AhmedYehia-M23/low-noise-microphone-preamplifier/simulation/ltspice/Microphone_Preamplifier_AD8656.asc

C1: polcap; 10µ; Rser=4 Lser=0 mfg="AVX" pn="TAJA106M006" type="Tantalum"
C2: Cap; 100nF
C3: Cap; 27nF
C5: Cap; 100nF
C6: Cap; 10µF
C7: polcap; 4.7µF
I1: current; SINE(250u 1u 1k); AC 1u
R1: res; 10K
R2: res; 10K
R3: Res; 47k
R4: Res; 2.2k
R5: Res; 22K
R6: Res; 220
R7: Res; 330
R8: Res; 100K
RPOT: Res; {Rpot}
U1: opamp2; AD8656
U2: opamp2; AD8656
V3: Voltage; 5V
Named nets: 0, VREF_RAW, VBIAS, VREF, LPF_OUT, 5V, MIC_OUT, AUDIO_OUT
Low-Noise Electret Microphone Preamplifier
5 V Supply & Decoupling
Mid-Supply Reference Generator (VREF_RAW)
Buffered Mid-Supply Reference (VREF)
Electret Microphone Input Stage
Main Gain Stage
Low-Pass Output Filter
AC-Coupled Audio Output
Simulation - 30 dB AC Response
.include ad8656.cir
.param Rpot=500
.ac dec 100 1 1Meg
.meas AC Gain_1k FIND db(V(audio_out)/V(mic_out)) AT=1k
.meas AC F_LOW WHEN db(V(audio_out)/V(mic_out))=26.5132 RISE=1
.meas AC F_HIGH WHEN db(V(audio_out)/V(mic_out))=26.5132 FALL=1
