AhmedYehia-M23/low-noise-microphone-preamplifier/simulation/ltspice/Microphone_Preamplifier_OPA165x.asc

C1: polcap; 10µ; Rser=4 Lser=0 mfg="AVX" pn="TAJA106M006" type="Tantalum"
C2: Cap; 100nF
C3: Cap; 27nF
C5: Cap; 100nF
C6: Cap; 10µF
C7: polcap; 4.7µF
I1: current; SINE(250u 5.1u 1k); AC 1
R1: res; 10K
R2: res; 10K
R3: Res; 47k
R4: Res; 2.2k
R5: Res; 22K
R6: Res; 220
R7: Res; 330
R8: Res; 100K
RPOT: Res; {Rpot}
U1: opamp2; OPA165x
U2: opamp2; OPA165x
V3: Voltage; 5V
Named nets: 0, VREF_RAW, VBIAS, VREF, LPF_OUT, 5V, MIC_OUT, AUDIO_OUT
.include OPA165x.LIB
.step param Rpot list 1 179 500
.ac dec 100 1 1Meg
.tran 10m
.param Rpot=500
Low-Noise Electret Microphone Preamplifier
5 V Supply & Decoupling
Mid-Supply Reference Generator (VREF_RAW)
Buffered Mid-Supply Reference (VREF)
Electret Microphone Input Stage
Main Gain Stage
Low-Pass Output Filter
AC-Coupled Audio Output
Simulation Commands
.op
