AhmedYehia-M23/low-noise-microphone-preamplifier/hardware/kicad/Microphone.kicad_pcb

## KiCad design hardware/kicad/Microphone.kicad_pcb (2026-10-14)

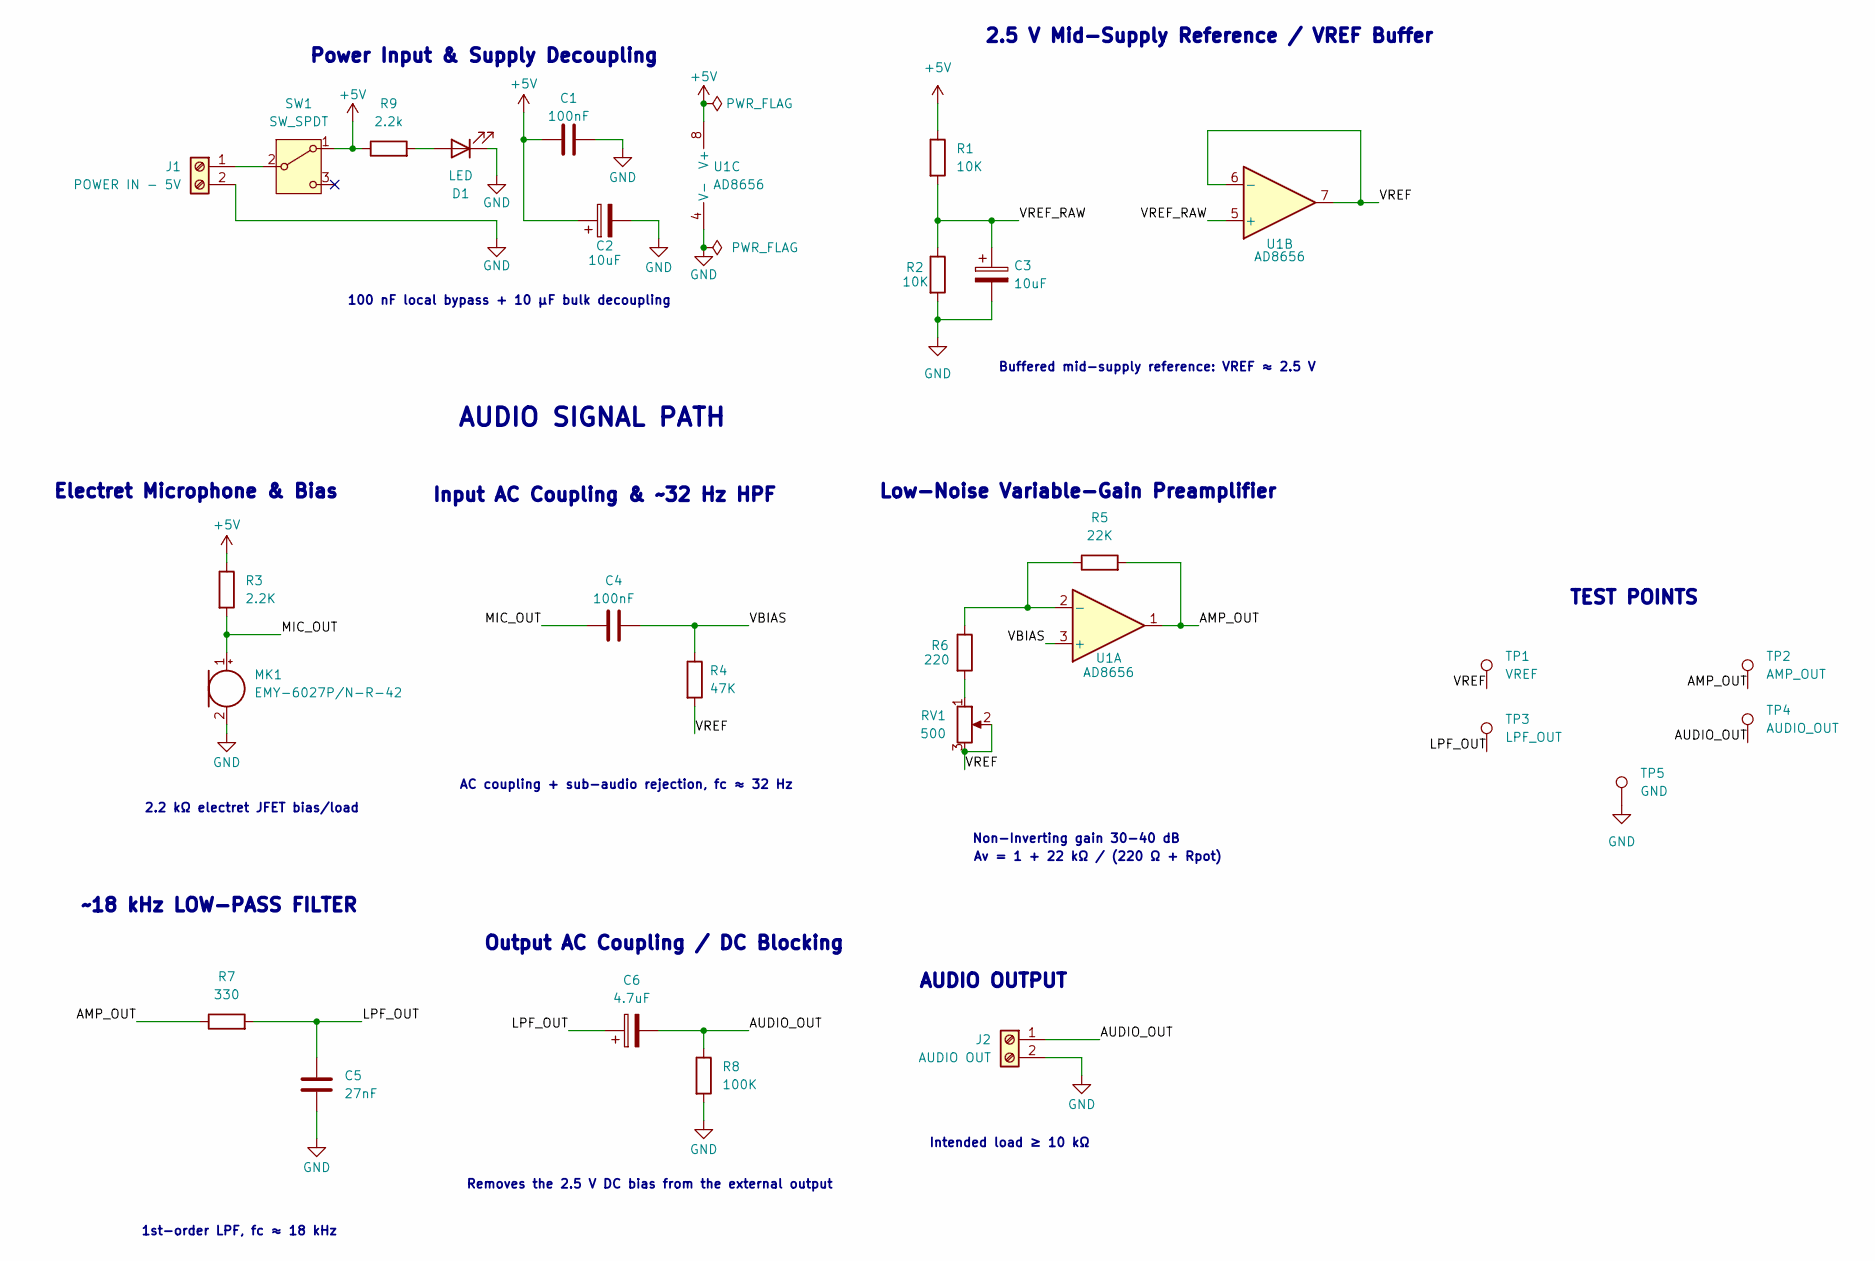
[picture p11: schematic Microphone.kicad_sch, Low-Noise Electret Microphone Preamplifier]

Parts:
C1, C4: 100nF; C_0603_1608Metric_Pad1.08x0.95mm_HandSolder
C2, C3: 10uF; CP_Elec_5x5.4
C5: 27nF; C_0603_1608Metric_Pad1.08x0.95mm_HandSolder
C6: 4.7uF; CP_Elec_4x5.8
D1: LED; LED_1206_3216Metric
J1: POWER IN - 5V; TerminalBlock_Phoenix_MKDS-1,5-2-5.08_1x02_P5.08mm_Horizont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
J2: AUDIO OUT; TerminalBlock_Phoenix_MKDS-1,5-2-5.08_1x02_P5.08mm_Horizont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
MK1: EMY-6027P/N-R-42; Microphone_EKULIT_EMY-6027PNR-42
R1, R2: 10K; R_0603_1608Metric_Pad0.98x0.95mm_HandSolder
R3: 2.2K; R_0603_1608Metric_Pad0.98x0.95mm_HandSolder
R4: 47K; R_0603_1608Metric_Pad0.98x0.95mm_HandSolder
R5: 22K; R_0603_1608Metric_Pad0.98x0.95mm_HandSolder
R6: 220; R_0603_1608Metric_Pad0.98x0.95mm_HandSolder
R7: 330; R_0603_1608Metric_Pad0.98x0.95mm_HandSolder
R8: 100K; R_0603_1608Metric_Pad0.98x0.95mm_HandSolder
R9: 2.2k; R_0603_1608Metric_Pad0.98x0.95mm_HandSolder
RV1: 500; Potentiometer_Piher_PT-10-H01_Horizontal
SW1: SW_SPDT; SW_ESP1010_SPDT_Vertical
TP1: VREF; TestPoint_THTPad_D2.0mm_Drill1.0mm
TP2: AMP_OUT; TestPoint_THTPad_D2.0mm_Drill1.0mm
TP3: LPF_OUT; TestPoint_THTPad_D2.0mm_Drill1.0mm
TP4: AUDIO_OUT; TestPoint_THTPad_D2.0mm_Drill1.0mm
TP5: GND; TestPoint_THTPad_D2.0mm_Drill1.0mm
U1: AD8656; MSOP-8_3x3mm_P0.65mm

Connections:
+5V: C1.1, C2.1, R1.1, R3.1, R9.1, SW1.1 (A), U1.8 (V+)
/AMP_OUT: R5.2, R7.1, TP2.1 (1_1), U1.1
/AUDIO_OUT: C6.2, J2.1, R8.1, TP4.1 (1_1)
/LPF_OUT: C5.1, C6.1, R7.2, TP3.1 (1_1)
/MIC_OUT: C4.2, MK1.1 (+), R3.2
/VBIAS: C4.1, R4.1, U1.3 (+)
/VREF: R4.2, RV1.2, RV1.3, TP1.1 (1_1), U1.6 (-), U1.7
/VREF_RAW: C3.1, R1.2, R2.1, U1.5 (+)
GND: C1.2, C2.2, C3.2, C5.2, D1.1 (K), J1.2, J2.2, MK1.2 (-), R2.2, R8.2, TP5.1 (1_1), U1.4 (V-)
unnamed: D1.2 (A), R9.2
unnamed: J1.1, SW1.2 (B)
unnamed: R6.2, RV1.1
unnamed: R5.1, R6.1, U1.2 (-)

Notes on the sheet:
AUDIO SIGNAL PATH
1st-order LPF, fc ≈ 18 kHz
AC coupling + sub-audio rejection, fc ≈ 32 Hz
100 nF local bypass + 10 µF bulk decoupling
Low-Noise Variable-Gain Preamplifier
Input AC Coupling & ~32 Hz HPF
Non-Inverting gain 30-40 dB
Buffered mid-supply reference: VREF ≈ 2.5 V
2.5 V Mid-Supply Reference / VREF Buffer
Output AC Coupling / DC Blocking
Electret Microphone & Bias
TEST POINTS
2.2 kΩ electret JFET bias/load
Power Input & Supply Decoupling
AUDIO OUTPUT
Intended load ≥ 10 kΩ
~18 kHz LOW-PASS FILTER
Av = 1 + 22 kΩ / (220 Ω + Rpot)
Removes the 2.5 V DC bias from the external output

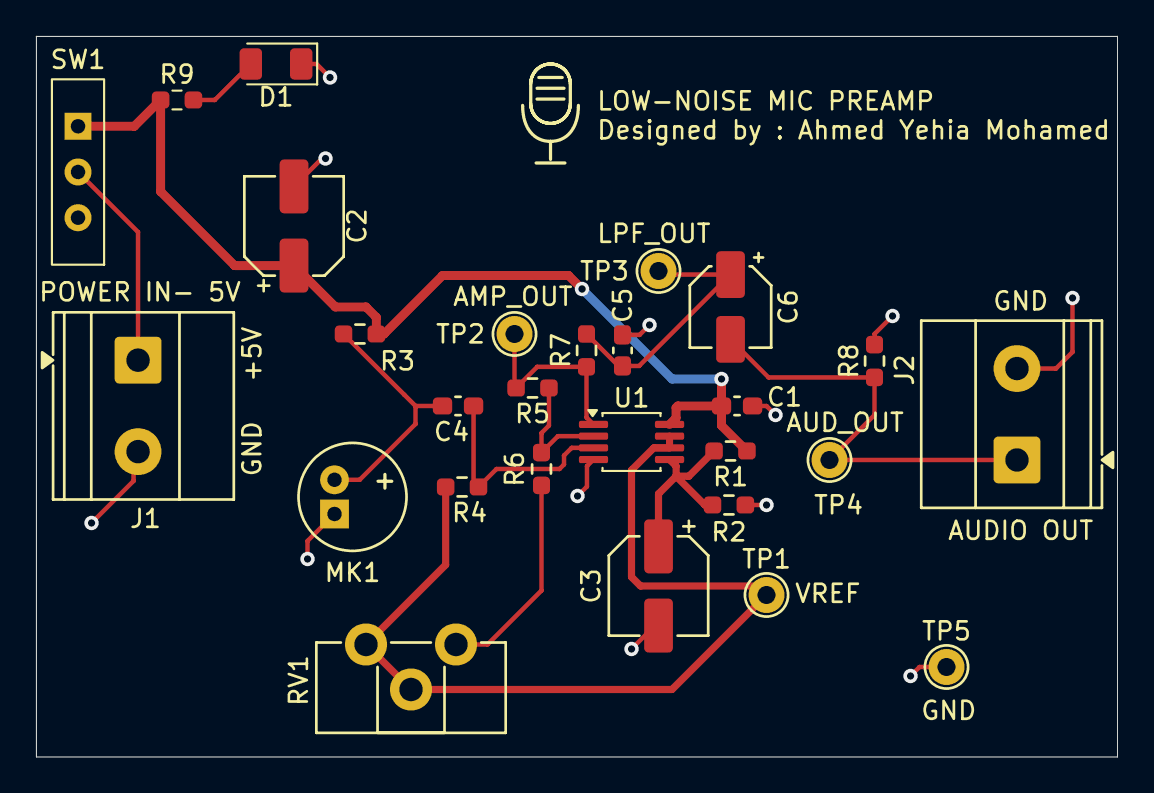
[picture p12: board Microphone.kicad_pcb from above]

Board: 2 copper layers, 60.1 x 40.0 mm, 27 parts (0 on the bottom side), 13 nets.
