AhmedYehia-M23/low-noise-microphone-preamplifier/(commit log)

2026-09-01 Initial release: low-noise microphone preamplifier
    [Microphone.kicad_pcb, Microphone.kicad_sch]
2026-10-12 Update microphone preamplifier PCB layout and schematic
    [Microphone.kicad_pcb, Microphone.kicad_sch]
2026-10-12 Refresh PCB layout screenshot to latest routing
2026-10-12 Refresh top and angled PCB 3D renders
2026-10-12 Improve schematic readability with high-contrast SVG and enlarged circuit views
2026-10-12 Use original KiCad light-theme SVG and remove schematic preview extras
2026-10-12 Add solid white background to KiCad schematic SVG preview
2026-10-14 Sync KiCad sources to manufactured AD8656 revision
    [Microphone.kicad_pcb, Microphone.kicad_sch]
2026-10-14 Update README for AD8656 PCBWay production revision
2026-10-14 Update schematic preview
2026-10-14 Show updated schematic
2026-10-14 Updated PCB layout image
2026-10-14 Updated PCB layout documentation
2026-10-14 Updated PCB 3D renders
2026-10-14 Updated LTspice schematic files
2026-10-14 Added AD8656 LTspice schematic screenshot
2026-10-14 Removed obsolete schematic and simulation images
2026-10-14 Added Analog Devices attribution
2026-10-14 Cleaned AD8656 LTspice schematic
2026-10-14 Corrected model license link and repository metadata
    [Microphone.kicad_pcb]
2026-10-14 Documented KiCad and LTspice reference mapping
2026-10-14 Added verified assembly bill of materials
    [BOM.csv]
